alex-dnd/power_board/README.md

# power_board — плата питания от аккумулятора 6S

Универсальная четырёхслойная плата питания. Питается от аккумулятора 6S (19,8–25,2 В) и выдаёт 7 В до 3 А, 5 В до 3 А и отдельный выход с напряжением батареи через самовосстанавливающийся предохранитель. Подписи выходов на плате (SERVO, POTOK, SK3500, ESP, RS485) остались от первого применения, использовать выходы можно для любой нагрузки в этих пределах.

Разведена вручную в KiCad 10.

## Выходы

| Разъём | Подпись | Напряжение | Откуда | Ток |
|---|---|---|---|---|
| J1 | BAT 6S | вход 19,8–25,2 В | аккумулятор | — |
| J2 | SERVO 7V | 7,06 В | LMR33630 (U2) | до 3 А |
| J3 | POTOK | напряжение батареи | через F2 1 А и FB1 | до 1 А |
| J4 | SK3500 | 5 В | U1 через LC-фильтр FB2 | до 1 А |
| J5 | ESP VIDEO | 5,02 В | LMR33630 (U1) | общие 3 А на J4–J7 |
| J6 | ESP SERVO | 5,02 В | U1 | |
| J7 | RS485 | 5,02 В | U1 | |

Квадратная площадка у каждого разъёма — «+», круглая — GND. Провода припаиваются в отверстия, клеммников нет.

## Схема

```
6S ─[F1 5 А]─[Q1 защита от переполюсовки]─[D2 TVS + C1 100 мкФ]─┬─ U1 LMR33630 → 5 В ─┬─ ESP32 ×2, RS485
                                                                │                      └─ FB2 + C19–C21 → SK3500
                                                                ├─ U2 LMR33630 → 7 В → сервопривод (D3 TVS, C15 470 мкФ)
                                                                └─ F2 1 А → FB1 → «Поток»
```

- U1 и U2: TI LMR33630BDDAR, 1,4 МГц, до 3 А. Номиналы обвязки взяты из [даташита TI](https://www.ti.com/lit/ds/symlink/lmr33630.pdf).
- Делитель 5 В: R2 100k / R3 24.9k. Делитель 7 В: R4 100k / R5 16.5k. Формула: Vout = 1 В × (1 + Rверх/Rниз).
- Защита от переполюсовки: P-канальный MOSFET Q1 SUD50P06-15, затвор через R1 на GND, стабилитрон D1 12 В ограничивает напряжение затвор–исток.

## Плата

| Параметр | Значение |
|---|---|
| Размер | 56,5 × 45 мм |
| Слои | 4: F.Cu сигналы + GND, In1 и In2 сплошная GND, B.Cu сигналы + GND |
| Толщина | 1,6 мм, фольга 35 мкм |
| Минимальная дорожка и зазор | 0,2 / 0,2 мм |
| Переходные отверстия | 0,6/0,3 и 0,8/0,4 мм |
| Дорожки SW → дроссель | 1,0 мм |
| Проверки | ERC 0, DRC 0 ошибок и 0 неразведённых (остались только предупреждения шелкографии) |

## Структура репозитория

```
kicad/   исходники KiCad: схема, плата, проект
gerber/  файлы для производства (Gerber + сверловка) и готовый архив power_board_gerber.zip
docs/    спецификация (BOM) и инструкция по заказу в Резоните
assembly/ файлы для заказа монтажа (BOM в Excel)
```

- [docs/zakaz_plat_rezonit.md](docs/zakaz_plat_rezonit.md) — как заказать платы в Резоните
- [docs/bom.md](docs/bom.md) — список деталей с номерами производителей

## Сборка и первое включение

- U1 и U2 имеют теплоотводящую площадку снизу. Паяльником их не припаять, нужен фен и паяльная паста.
- Первое включение делать от лабораторного блока питания: 20–24 В, ограничение тока 100–200 мА, без нагрузки. Проверить 5 В и 7 В мультиметром, только потом подключать нагрузку и аккумулятор.
