alex-dnd/power_board/docs/bom.md

# Спецификация (BOM)

Всего 51 позиция на плате, из них J1–J7 не устанавливаются: это отверстия под провода.

| Позиции | Номинал | Корпус | MPN | Производитель | Шт. |
|---|---|---|---|---|---|
| U1, U2 | LMR33630BDDA | HSOIC-8 с площадкой | LMR33630BDDAR | TI | 2 |
| Q1 | P-MOSFET −60 В 50 А | TO-252 | SUD50P06-15-GE3 | Vishay | 1 |
| D1 | стабилитрон 12 В | SOD-123 | MMSZ5242BT1G | onsemi | 1 |
| D2 | TVS 26 В двунапр. | SMB | SMBJ26CA | Littelfuse | 1 |
| D3 | TVS 7,5 В двунапр. | SMB | SMBJ7.5CA | Littelfuse | 1 |
| F1 | 5 А, 32 В | 1206 | 1206SFS500F/32 | Littelfuse | 1 |
| F2 | 1,1 А самовосст. | 1812 | 1812L110/33MR | Littelfuse | 1 |
| FB1, FB2 | феррит 600 Ом | 1206 | BLM31KN601SN1L | Murata | 2 |
| L1 | 2,2 мкГн | 7,3 × 6,6 мм | SRP7028A-2R2M | Bourns | 1 |
| L2 | 4,7 мкГн | 7,3 × 6,6 мм | SRP7028A-4R7M | Bourns | 1 |
| R1, R2, R4 | 100k 1% | 0805 | RC0805FR-07100KL | Yageo | 3 |
| R3 | 24.9k 1% | 0805 | RC0805FR-0724K9L | Yageo | 1 |
| R5 | 16.5k 1% | 0805 | RC0805FR-0716K5L | Yageo | 1 |
| C5, C11, C18, C20, C23, C25, C27 | 100 нФ 50 В | 0805 | CL21B104KBCNNNC | Samsung | 7 |
| C3, C9 | 220 нФ 50 В | 0805 | CL21B224KBFNNNE | Samsung | 2 |
| C4, C10 | 1 мкФ 16 В | 0805 | CL21B105KOFNNNE | Samsung | 2 |
| C17, C19, C26 | 10 мкФ 16 В | 0805 | CL21A106KOQNNNE | Samsung | 3 |
| C2, C8 | 10 мкФ 50 В | 1206 | CL31A106KBHNNNE | Samsung | 2 |
| C6, C7, C12, C13, C14 | 22 мкФ 16 В | 1206 | CL31A226KOHNNNE | Samsung | 5 |
| C1, C16 | 100 мкФ 50 В | электролит 10 × 10,2 мм | EEE-FC1H101P | Panasonic | 2 |
| C15 | 470 мкФ 16 В | электролит 8 × 10,2 мм | EEE-FK1C471P | Panasonic | 1 |
| C22, C24 | 100 мкФ 35 В | электролит 6,3 × 7,7 мм, 105 °C | EEE-FK1V101XP | Panasonic | 2 |
| C21 | 47 мкФ 16 В | электролит 5 × 5,4 мм, 105 °C | CD016M470D5APKKKV00R (аналог EEE-FK1C470UR, 5 × 5,8 мм) | SUSCON | 1 |
| J1–J7 | — | отверстия под провода | не устанавливать | — | — |

## Замечания

- C1 и C16: не путать с EEE-FK1H101P, у него диаметр 8 мм, а посадочное место рассчитано на 10 мм. Подойдёт любой 100 мкФ 50 В размером 10 × 10,2 мм.
- F1: исходно стоял 0468003.NR (3 А). Заменён на 5 А, потому что 3 А мало при максимальной нагрузке на серво и 5 В одновременно.
- D3: при желании можно поставить SMBJ8.0CA (корпус тот же), если серво рассчитано на 8,4 В.
- Номера керамических конденсаторов и резисторов подобраны по маркировке серий Samsung CL и Yageo RC. Перед покупкой сверьте номинал и напряжение в магазине.
