alex-dnd/power_board/assembly/power_board_BOM.xlsx

Спецификация (BOM): power_board, монтаж с одной стороны (TOP)
№ | Позиционные обозначения | Наименование | Корпус | Парт-номер (MPN) | Производитель | Кол-во на плату | Устанавливать | Аналог
1 | U1, U2 | Микросхема DC-DC 3 А | HSOIC-8 с термоплощадкой | LMR33630BDDAR | Texas Instruments | 2 | Да | По согласованию
2 | Q1 | P-MOSFET −60 В 50 А | TO-252 (DPAK) | SUD50P06-15-GE3 | Vishay | 1 | Да | По согласованию
3 | D1 | Стабилитрон 12 В 0,5 Вт | SOD-123 | MMSZ5242BT1G | onsemi | 1 | Да | По согласованию
4 | D2 | TVS-диод 26 В, двунаправленный | SMB (DO-214AA) | SMBJ26CA | Littelfuse | 1 | Да | По согласованию
5 | D3 | TVS-диод 7,5 В, двунаправленный | SMB (DO-214AA) | SMBJ7.5CA | Littelfuse | 1 | Да | По согласованию
6 | F1 | Предохранитель 5 А 32 В | 1206 | 1206SFS500F/32 | Littelfuse | 1 | Да | По согласованию
7 | F2 | Самовосстанавливающийся предохранитель 1,1 А | 1812 | 1812L110/33MR | Littelfuse | 1 | Да | По согласованию
8 | FB1, FB2 | Ферритовая бусина 600 Ом | 1206 | BLM31KN601SN1L | Murata | 2 | Да | По согласованию
9 | L1 | Дроссель 2,2 мкГн | 7,3 × 6,6 мм | SRP7028A-2R2M | Bourns | 1 | Да | По согласованию
10 | L2 | Дроссель 4,7 мкГн | 7,3 × 6,6 мм | SRP7028A-4R7M | Bourns | 1 | Да | По согласованию
11 | R1, R2, R4 | Резистор 100 кОм 1% | 0805 | RC0805FR-07100KL | Yageo | 3 | Да | Допускается
12 | R3 | Резистор 24,9 кОм 1% | 0805 | RC0805FR-0724K9L | Yageo | 1 | Да | Допускается
13 | R5 | Резистор 16,5 кОм 1% | 0805 | RC0805FR-0716K5L | Yageo | 1 | Да | Допускается
14 | C5, C11, C18, C20, C23, C25, C27 | Конденсатор 100 нФ 50 В X7R | 0805 | CL21B104KBCNNNC | Samsung | 7 | Да | Допускается
15 | C3, C9 | Конденсатор 220 нФ 50 В X7R | 0805 | CL21B224KBFNNNE | Samsung | 2 | Да | Допускается
16 | C4, C10 | Конденсатор 1 мкФ 16 В X7R | 0805 | CL21B105KOFNNNE | Samsung | 2 | Да | Допускается
17 | C17, C19, C26 | Конденсатор 10 мкФ 16 В X5R | 0805 | CL21A106KOQNNNE | Samsung | 3 | Да | Допускается
18 | C2, C8 | Конденсатор 10 мкФ 50 В X5R | 1206 | CL31A106KBHNNNE | Samsung | 2 | Да | Допускается
19 | C6, C7, C12, C13, C14 | Конденсатор 22 мкФ 16 В X5R | 1206 | CL31A226KOHNNNE | Samsung | 5 | Да | Допускается
20 | C1, C16 | Конденсатор электролит. 100 мкФ 50 В, 105 °C | 10 × 10,2 мм | EEE-FC1H101P | Panasonic | 2 | Да | Допускается
21 | C15 | Конденсатор электролит. 470 мкФ 16 В, 105 °C | 8 × 10,2 мм | EEE-FK1C471P | Panasonic | 1 | Да | Допускается
22 | C22, C24 | Конденсатор электролит. 100 мкФ 35 В, 105 °C | 6,3 × 7,7 мм | EEE-FK1V101XP | Panasonic | 2 | Да | Допускается
23 | C21 | Конденсатор электролит. 47 мкФ 16 В, 105 °C | 5 × 5,4 мм | CD016M470D5APKKKV00R | SUSCON | 1 | Да | Допускается
24 | J1–J7 | Отверстия под провода (разъёмов нет) | — | — | — | 0 | Нет, не устанавливать | —
 | Итого деталей на плату:
 | Примечание: монтаж только с верхней стороны. J1–J7 — отверстия для проводов, компоненты не устанавливаются. Квадратная площадка = «+».
