alex-dnd/power_board/kicad/power_board.kicad_pcb

## KiCad design kicad/power_board.kicad_pcb (2026-11-01)

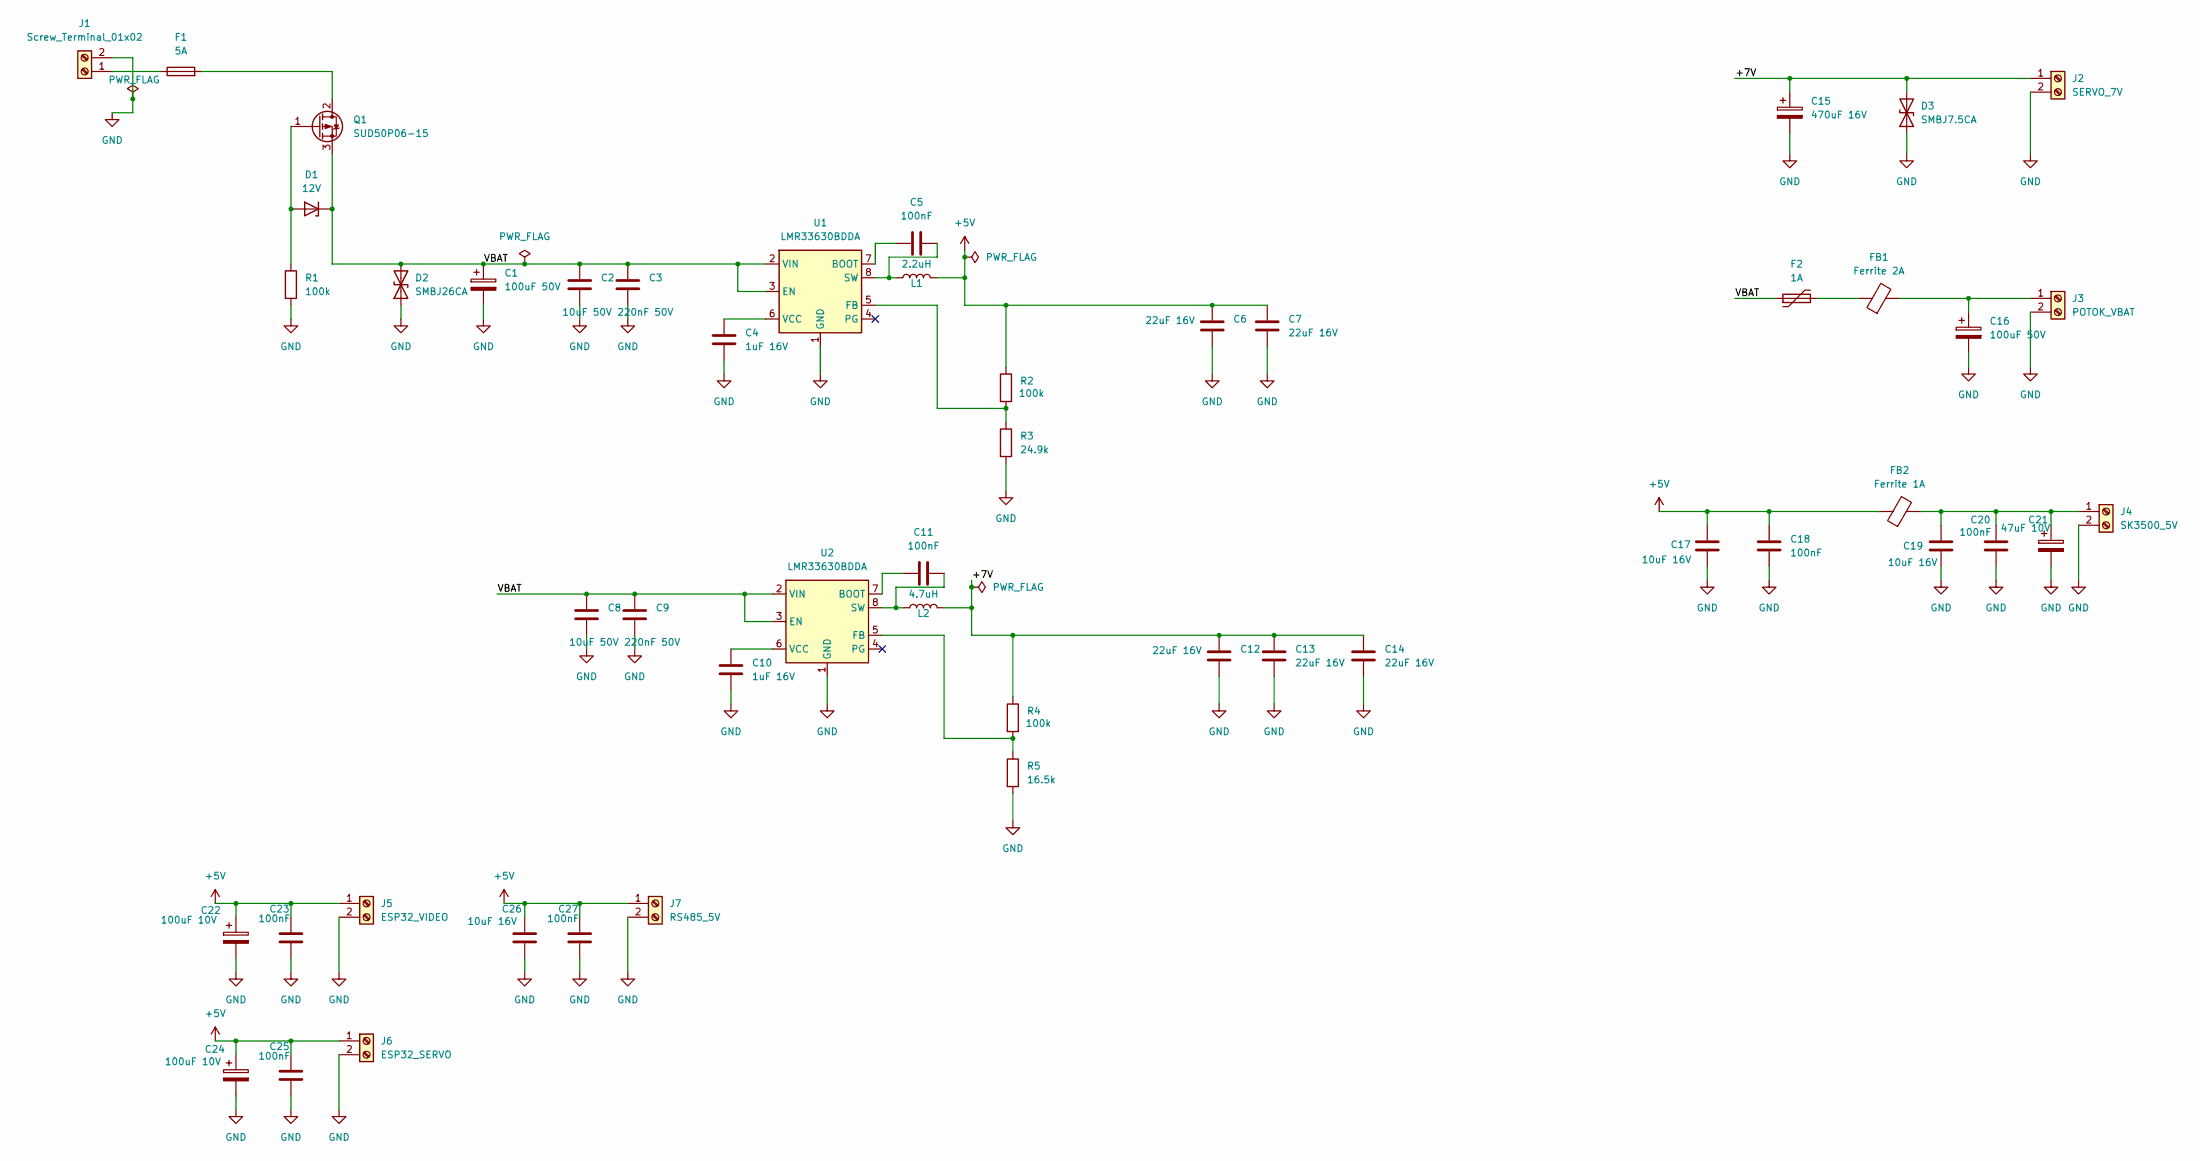
[picture p1: schematic power_board.kicad_sch]

Parts:
C1, C16: 100uF 50V; CP_Elec_10x10
C2, C8: 10uF 50V; C_1206_3216Metric
C3, C9: 220nF 50V; C_0805_2012Metric
C4, C10: 1uF 16V; C_0805_2012Metric
C5, C11, C18, C20, C23, C25, C27: 100nF; C_0805_2012Metric
C6, C7, C12, C13, C14: 22uF 16V; C_1206_3216Metric
C15: 470uF 16V; CP_Elec_8x10
C17, C19, C26: 10uF 16V; C_0805_2012Metric
C21: 47uF 10V; CP_Elec_5x5.4
C22, C24: 100uF 10V; CP_Elec_6.3x7.7
D1: 12V; D_SOD-123
D2: SMBJ26CA; D_SMB
D3: SMBJ7.5CA; D_SMB
F1: 5A; Fuse_1206_3216Metric
F2: 1A; Fuse_1812_4532Metric
FB1: Ferrite 2A; L_1206_3216Metric
FB2: Ferrite 1A; L_1206_3216Metric
J1: Screw_Terminal_01x02; SolderWire-0.5sqmm_1x02_P4.6mm_D0.9mm_OD2.1mm
J2: SERVO_7V; SolderWire-0.5sqmm_1x02_P4.6mm_D0.9mm_OD2.1mm
J3: POTOK_VBAT; SolderWire-0.25sqmm_1x02_P4.2mm_D0.65mm_OD1.7mm
J4: SK3500_5V; SolderWire-0.25sqmm_1x02_P4.2mm_D0.65mm_OD1.7mm
J5: ESP32_VIDEO; SolderWire-0.25sqmm_1x02_P4.2mm_D0.65mm_OD1.7mm
J6: ESP32_SERVO; SolderWire-0.25sqmm_1x02_P4.2mm_D0.65mm_OD1.7mm
J7: RS485_5V; SolderWire-0.25sqmm_1x02_P4.2mm_D0.65mm_OD1.7mm
L1: 2.2uH; L_Bourns_SRP7028A_7.3x6.6mm
L2: 4.7uH; L_Bourns_SRP7028A_7.3x6.6mm
Q1: SUD50P06-15; TO-252-2
R1, R2, R4: 100k; R_0805_2012Metric
R3: 24.9k; R_0805_2012Metric
R5: 16.5k; R_0805_2012Metric
U1, U2: LMR33630BDDA; Texas_HSOP-8-1EP_3.9x4.9mm_P1.27mm_ThermalVias

Connections:
+5V: C6.1, C7.1, C17.1, C18.1, C22.1, C23.1, C24.1, C25.1, C26.1, C27.1, FB2.1, J5.1, J6.1, J7.1, L1.2, R2.1
/+7V: C12.1, C13.1, C14.1, C15.1, D3.2 (A2), J2.1, L2.2, R4.1
/VBAT: C1.1, C2.1, C3.1, C8.1, C9.1, D1.1 (K), D2.2 (A2), F2.1, Q1.3 (S), U1.2 (VIN), U1.3 (EN), U2.2 (VIN), U2.3 (EN)
GND: C1.2, C2.2, C3.2, C4.2, C6.2, C7.2, C8.2, C9.2, C10.2, C12.2, C13.2, C14.2, C15.2, C16.2, C17.2, C18.2, C19.2, C20.2, C21.2, C22.2, C23.2, C24.2, C25.2, C26.2, C27.2, D2.1 (A1), D3.1 (A1), J1.2, J2.2, J3.2, J4.2, J5.2, J6.2, J7.2, R1.2, R3.2, R5.2, U1.1 (GND), U1.9 (GND), U2.1 (GND), U2.9 (GND)
unnamed: D1.2 (A), Q1.1 (G), R1.1
unnamed: F2.2, FB1.1
unnamed: F1.1, J1.1
unnamed: C16.1, FB1.2, J3.1
unnamed: C19.1, C20.1, C21.1, FB2.2, J4.1
unnamed: F1.2, Q1.2 (D)
unnamed: C5.1, U1.7 (BOOT)
unnamed: R2.2, R3.1, U1.5 (FB)
unnamed: C5.2, L1.1, U1.8 (SW)
unnamed: C4.1, U1.6 (VCC)
unnamed: C11.1, U2.7 (BOOT)
unnamed: R4.2, R5.1, U2.5 (FB)
unnamed: C11.2, L2.1, U2.8 (SW)
unnamed: C10.1, U2.6 (VCC)

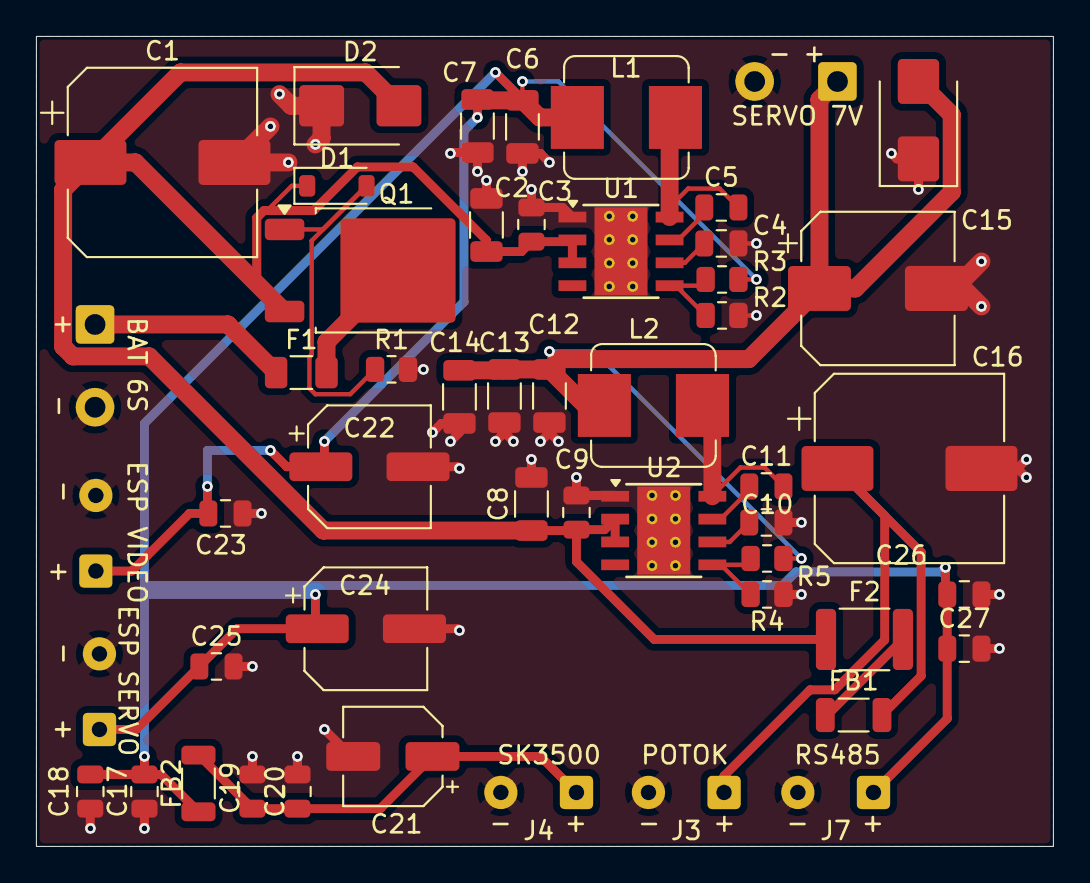
[picture p2: board power_board.kicad_pcb from above]

Board: 4 copper layers, 56.5 x 45.0 mm, 51 parts (0 on the bottom side), 18 nets.
