alex-dnd/power_board/(commit log)

2026-11-01 Плата питания 6S: исходники KiCad, Gerber, BOM и инструкция по заказу
    [power_board-B_Cu.gbl, power_board-B_Mask.gbs, power_board-B_Paste.gbp, power_board-B_Silkscreen.gbo, power_board-Edge_Cuts.gm1, power_board-F_Cu.gtl, power_board-F_Mask.gts, power_board-F_Paste.gtp]
2026-11-01 BOM для монтажа: Excel, точные номера C21, C22, C24
    [power_board_BOM.xlsx]
2026-11-01 Pick&Place для монтажа
